patfelst/waveshare-p4-88-dsi/assets/README.md

# Build graphics

Fusion views of the `Waveshare P4 bracket` assembly and the editable connection diagram used in the [build guide](../README.md).
