patfelst/waveshare-p4-88-dsi/firmware/waveshare_pr_components/mipi_dsi/models/README.md

# MIPI DSI panel models

The Waveshare 8.8-inch panel is defined in [waveshare.py](waveshare.py) as `WAVESHARE-8.8-DSI-TOUCH-A`. Keep the model modules together with the [driver](../display.py). See the [ESPHome license](../../../ESPHome-LICENSE.txt).
