patfelst/waveshare-p4-88-dsi/hardware/p4-lcd-bracket.step

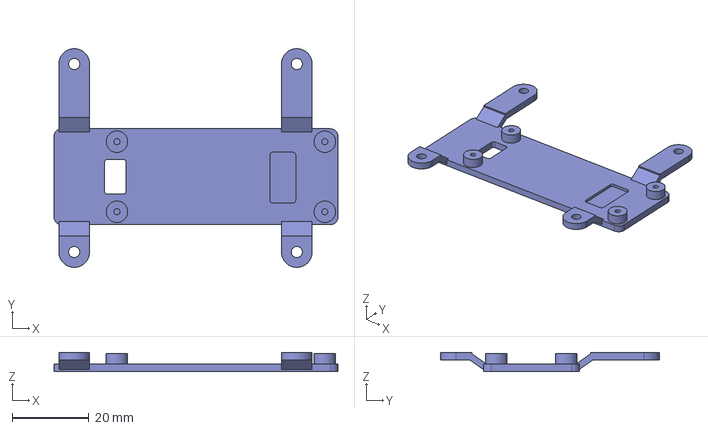
[picture p4: CAD file, 2026-11-08]
hardware/p4-lcd-bracket.step
74.0 x 57.0 x 5.00 mm
