patfelst/waveshare-p4-88-dsi/(list of files, cad)

Other CAD files:
hardware/p4-lcd-bracket.stl
