patfelst/waveshare-p4-88-dsi/firmware/p4-88-bringup.yaml

# Waveshare ESP32-P4-WIFI6-DB + 8.8-DSI-TOUCH-A bring-up test.
# Board: https://docs.waveshare.com/ESP32-P4-WIFI6-DB
# Display source: waveshareteam/Waveshare-ESP32-components commit
# 07d2d0630ec03bf23a21d8f28c1c815fe00a4fa4, display/lcd/esp_lcd_ota7290b.
# P4 silicon revision 3.2 and 32MB flash confirmed by serial flash/boot logs.
# Native hardware bars and software framebuffer verified on this board/display.
esphome:
  name: waveshare-p4-db-88-test
  friendly_name: Waveshare P4 DB 8.8 Test
  min_version: 2026.9.0
  on_boot:
    - priority: 850
      then:
        # After I2C bus setup (1000), before display/touch setup.
        # Blocking waits deliberately keep display setup behind panel power-up.
        - lambda: |-
            // The named model supplies reset policy and the DCS command table.
            // Separate I2C control path, not DSI pixel/command traffic:
            // replay Waveshare's 0x95 control and 0x96 backlight startup writes.
            bool ok = id(panel_control).write_byte(0x95, 0x11);
            ok = id(panel_control).write_byte(0x95, 0x17) && ok;
            ok = id(panel_control).write_byte(0x96, 0x00) && ok;
            delay(100);
            ok = id(panel_control).write_byte(0x96, 0xFF) && ok;
            delay(1000);
            if (!ok) ESP_LOGE("panel_power", "Panel I2C power sequence failed at 0x45");
    - priority: -100
      then:
        - light.turn_on:
            id: panel_backlight
            brightness: 70%

# Clean local backport of the upstream PR candidate. Only mipi_dsi is replaced.
# The named WAVESHARE-8.8-DSI-TOUCH-A model skips software reset, while retaining
# the normal DPI startup order. No panel-ID read or diagnostic startup flag.
# Its model definition supplies panel timings/commands; no C++ sequence override.
# Keep waveshare_pr_components beside this YAML for future builds and updates.
# This backport uses the proven pinned driver; the PR patch targets upstream dev.
external_components:
  - source:
      type: local
      path: waveshare_pr_components
    components: [mipi_dsi]
esp32:
  variant: esp32p4
  engineering_sample: false
  cpu_frequency: 360MHz
  flash_size: 32MB # External NOR flash, separate from the 32MB in-package PSRAM.
  framework:
    type: esp-idf
    # ESP-IDF host-side library used by esp32_hosted below. This pinned version
    # provides the P4-to-C5 transport; the C5 needs compatible slave firmware.
    components:
      - name: espressif/esp_hosted
        ref: "2.12.13"
    advanced:
      enable_idf_experimental_features: true
psram:
  mode: hex
  speed: 200MHz
# P4's internal adjustable regulator channel 3 powers the MIPI DSI PHY at 2.5 V.
# The PHY is the electrical interface that drives the high-speed display lanes.
# This is separate from the display's external 5 V supply and backlight setting.
esp_ldo:
  channel: 3
  voltage: 2.5V
logger:
  hardware_uart: UART0
  level: DEBUG
api:
  encryption:
    key: !secret api_key
  reboot_timeout: 0s
ota:
  - platform: esphome
# The ESP32-P4 has no integrated Wi-Fi radio. ESP-Hosted lets its ESPHome firmware
# use the board's ESP32-C5 wireless coprocessor over the dedicated SDIO bus.
# These pins connect the two chips on the PCB; they are not SD-card/display pins.
# wifi: below supplies the network credentials; this block supplies its transport.
# This configuration does not install/update the C5's own slave firmware.
esp32_hosted:
  type: sdio
  variant: ESP32C5
  reset_pin: GPIO54
  active_high: true
  cmd_pin: GPIO19
  clk_pin: GPIO18
  d0_pin: GPIO14
  d1_pin: GPIO15
  d2_pin: GPIO16
  d3_pin: GPIO17
  sdio_frequency: 10MHz
  use_psram: true
# Requires compatible C5 ESP-Hosted slave firmware. No coprocessor updater here.
wifi:
  id: board_wifi
  networks:
    - ssid: !secret wifi_ssid
      password: !secret wifi_password
  reboot_timeout: 0s

# Shared low-speed control bus on GPIO7 (SDA) and GPIO8 (SCL).
# Confirmed scan addresses on this setup:
#   0x45: display control/backlight; used by panel_control and the light output.
#   0x5D: Goodix GT9271 touchscreen; accessed through ESPHome's gt911 driver.
#   0x18: onboard ES8311 audio codec; detected, but audio is not configured here.
# A camera, if fitted, can also share these lines for SCCB control.
# Image pixels travel over MIPI DSI, not over I2C; touch/control use this bus.
# Board reference: https://docs.waveshare.com/ESP32-P4-WIFI6-DB#peripheral-quick-reference
i2c:
  id: board_i2c
  sda: GPIO7
  scl: GPIO8
  frequency: 100kHz
  scan: true # Log responding addresses at startup; useful for wiring checks.
# Generic access to the display's controller at 0x45. Register 0x96 controls
# backlight brightness (0..255); register 0x95 is used in Waveshare's startup.
i2c_device:
  id: panel_control
  i2c_id: board_i2c
  address: 0x45
output:
  - platform: template
    id: backlight_output
    type: float
    write_action:
      - lambda: |-
          const uint8_t value = static_cast<uint8_t>(state * 255.0f + 0.5f);
          if (!id(panel_control).write_byte(0x96, value))
            ESP_LOGW("backlight", "I2C brightness write failed");
light:
  - platform: monochromatic
    id: panel_backlight
    name: Display Backlight
    output: backlight_output
    gamma_correct: 1.0
    default_transition_length: 0s
    restore_mode: ALWAYS_ON

display:
  - platform: mipi_dsi
    id: lcd
    model: WAVESHARE-8.8-DSI-TOUCH-A
    dimensions:
      width: 480
      height: 1920
    # OTA7290B startup deliberately omits software reset, matching the native test.
    transform: disabled
    color_order: RGB
    pixel_mode: 16bit
    color_depth: 16
    lanes: 2
    lane_bit_rate: 1300Mbps
    pclk_frequency: 75MHz
    hsync_pulse_width: 50
    hsync_back_porch: 50
    hsync_front_porch: 50
    vsync_pulse_width: 20
    vsync_back_porch: 20
    vsync_front_porch: 20
    update_interval: never
    auto_clear_enabled: false
    # Initialization commands and required delays come from the named model.

touchscreen:
  - platform: gt911 # GT9271 uses the Goodix GT9xx register protocol.
    id: touch
    display: lcd
    i2c_id: board_i2c
    address: 0x5D # Check I2C scan; some Goodix configurations use 0x14.
    update_interval: 20ms
    # Log touch coordinates while LVGL handles the test button.
    on_touch:
      - lambda: |-
          ESP_LOGI("touch_test", "native=(%d,%d) raw=(%d,%d)",
                   touch.x, touch.y, touch.x_raw, touch.y_raw);


    on_release:
      - logger.log: "Touch released"

# Landscape LVGL test pattern with a touch-response button.
lvgl:
  rotation: 90
  draw_rounding: 32
  pad_all: 0
  border_width: 0
  scrollable: false
  displays: [lcd]
  touchscreens: [touch]
  color_depth: 16
  buffer_size: 25%
  default_font: montserrat_24
  pages:
    - id: test_page
      bg_color: 0x101A2A
      widgets:
        - label:
            text: "Waveshare 8.8-inch | LVGL display test"
            x: 40
            y: 30
            text_color: 0xFFFFFF
        - label:
            text: "1920 x 480 | RGB bars | Touch the button below"
            x: 40
            y: 75
            text_color: 0xC0D0E0
        - obj:
            x: 40
            y: 130
            width: 263
            height: 200
            bg_color: 0xFF0000
            border_width: 0
            radius: 0
        - obj:
            x: 303
            y: 130
            width: 263
            height: 200
            bg_color: 0x00FF00
            border_width: 0
            radius: 0
        - obj:
            x: 566
            y: 130
            width: 263
            height: 200
            bg_color: 0x0000FF
            border_width: 0
            radius: 0
        - obj:
            x: 829
            y: 130
            width: 263
            height: 200
            bg_color: 0x00FFFF
            border_width: 0
            radius: 0
        - obj:
            x: 1092
            y: 130
            width: 263
            height: 200
            bg_color: 0xFF00FF
            border_width: 0
            radius: 0
        - obj:
            x: 1355
            y: 130
            width: 263
            height: 200
            bg_color: 0xFFFF00
            border_width: 0
            radius: 0
        - obj:
            x: 1618
            y: 130
            width: 263
            height: 200
            bg_color: 0xFFFFFF
            border_width: 0
            radius: 0
        - button:
            x: 40
            y: 370
            width: 420
            height: 70
            widgets:
              - label:
                  id: touch_result
                  text: "Tap to test touch"
                  align: CENTER
            on_click:
              - lvgl.label.update:
                  id: touch_result
                  text: "Touch OK"
