patfelst/waveshare-p4-88-dsi/(commit log)

2026-11-08 Add Fusion renders and colour wiring diagram
2026-11-08 Add printable bracket STL and editable STEP
    [p4-lcd-bracket.step, p4-lcd-bracket.stl]
2026-11-08 Remove Rack info and document the browsable driver
2026-11-08 Link to the firmware and driver source from the build guide
2026-11-08 Use a minimal LVGL bring-up pattern and explain the custom driver
